andrewpatcarr/Origami-Robot/README.md

Origami-Robot
----
----
General repository for the origami worm
----

Programming has code for control of robot

CAD has all existing models for structures, mounts and other pieces of origami robot

log.md is a running log of work with the robot starting with my work in ME-400 in Fall 2024
