andrewpatcarr/Origami-Robot/log_photos/joystick_arduino_housing.jpg

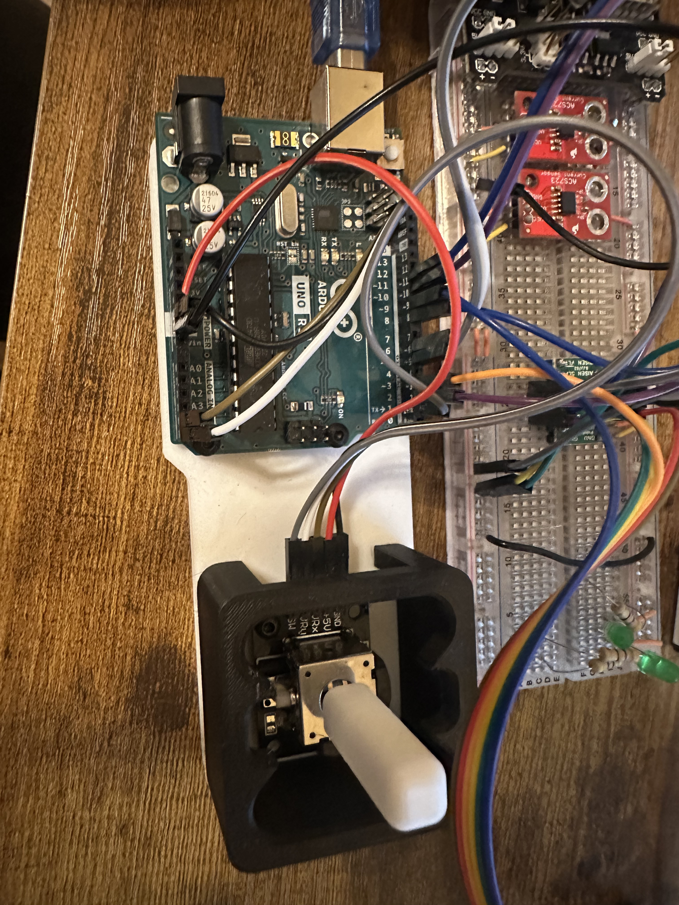
log_photos/joystick_arduino_housing.jpg
