andrewpatcarr/Origami-Robot/log_photos/motor_driver_screenshot_wordless.png

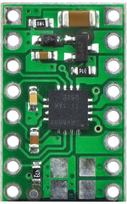
log_photos/motor_driver_screenshot_wordless.png
