andrewpatcarr/Origami-Robot/log_photos/origami_pattern.png

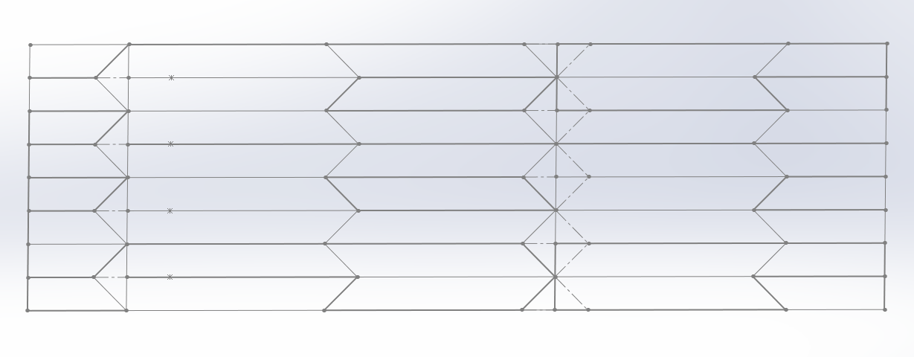
log_photos/origami_pattern.png
