andrewpatcarr/Origami-Robot/log_photos/worm_image_for_dim.jpg

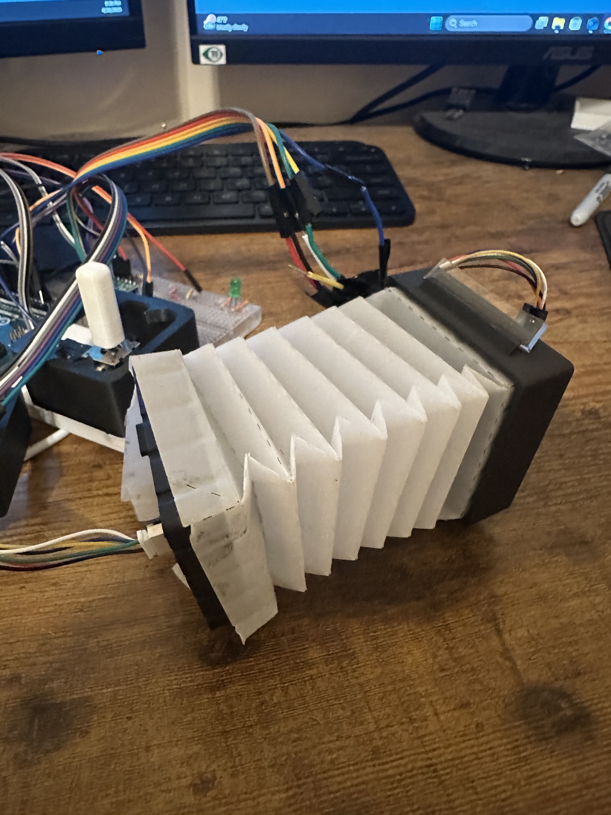
log_photos/worm_image_for_dim.jpg
