andrewpatcarr/Origami-Robot/Bill of Materials.xlsx

# | ITEM | Quantity | Price | Link | Total Price | Comments | Cost of materials
1 | Pololu 298:1 Micro Metal Gearmotor MP 6V with 12 CPR Encoder, Side Connector | 2 | $25.95 | www.pololu.com/product/5147 | $51.90 |  | $179.06
2 | Pololu DRV8833 Dual Motor Driver Carrier | 1 | $9.95 | www.pololu.com/product/2130 | $9.95 |  | without tax/shipping
3 | Arduino Uno R3 | 1 | $29.00 | www.amazon.com/Arduino-A000066-ARDUINO-UNO-R3 | $29.00 | can use offbrand one and will be cheaper
4 | Analog Joystick | 1 | $9.99 | www.amazon.com/Joystick-Controller | $9.99 | will have different base joystick so will need to change printed joystick to fit
5 | 6 Pin JST SH 1.0mm Cable Connector | 1 | $9.49 | www.amazon.com/dp/B0BKSNMC (https://www.amazon.com/dp/B0BKSNMCV4?ref=ppx_yo2ov_dt_b_fed_asin_title) | $9.49
6 | M1.6 x 3mm Round Flat Head Machine Screws | 1 | $5.99 | www.amazon.com/dp/B0CTMKH2CX (https://www.amazon.com/dp/B0CTMKH2CX?ref=ppx_yo2ov_dt_b_fed_asin_title&th=1) | $5.99
7 | PLA Filament | 1 | $13.99 | www.amazon.com/ELEGOO-Filament-Dimensional | $13.99
8 | Breadboard Power Supply Module | 1 | $6.99 | www.amazon.com/DIYables-Breadboard-Supply | $6.99
9 | Breadboard | 1 | $8.79 | www.amazon.com/Breadboards (https://www.amazon.com/Breadboards-Solderless-Breadboard-Distribution-Connecting/dp/B07DL13RZH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) | $8.79
10 | Multicolored Dupont Wire 120 pcs | 1 | $6.98 | www.amazon.com/Multicolored (https://www.amazon.com/Elegoo-EL-CP-004-Multicolored-Breadboard-arduino/dp/B01EV70C78) | $6.98
11 | Machine Screw Assortment Kit, M2 M3 M4 M5 | 1 | $25.99 | www.amazon.com/Machine-Assortment-Metric- | $25.99
12
13
14
15
16
17
18
19
20
21
