andrewpatcarr/Origami-Robot/CAD/SolidWorks/DC Pulley.SLDPRT

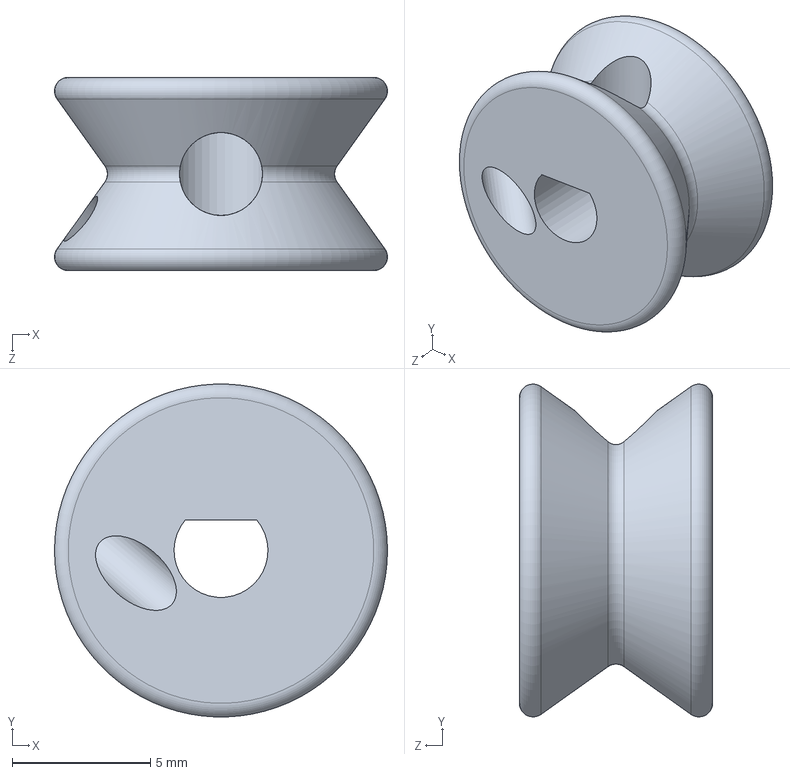
[picture p67: CAD file, 2025-03-13]
CAD/SolidWorks/DC Pulley.SLDPRT
12.1 x 12.0 x 7.00 mm
