andrewpatcarr/Origami-Robot/CAD/STLs/DC Motor/DC Motor Mount.STL

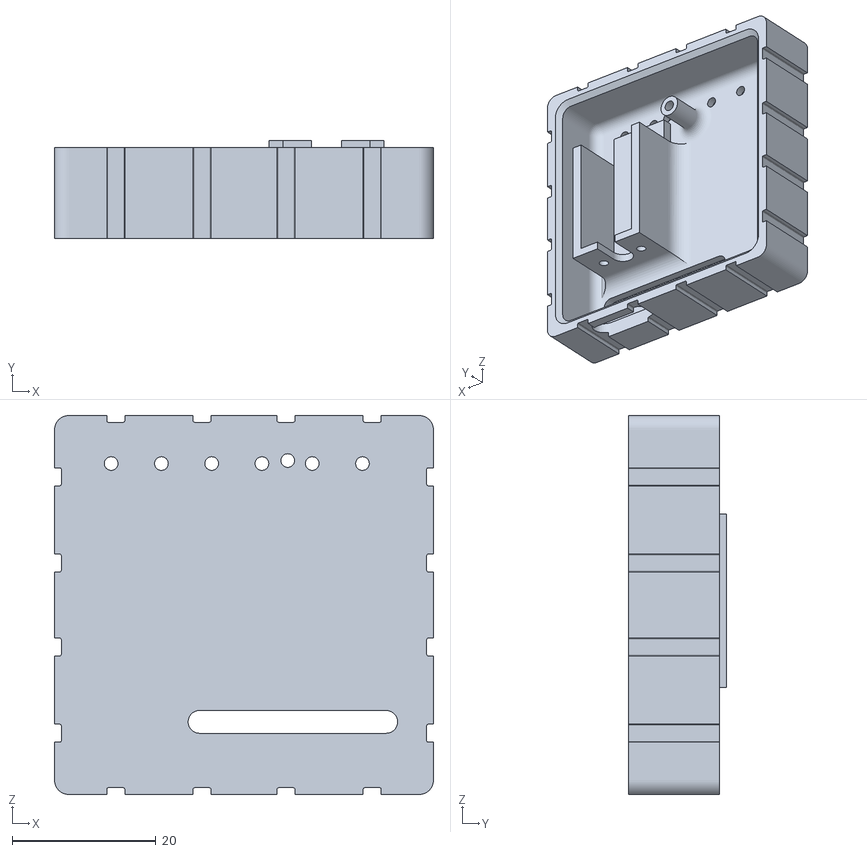
[picture p68: CAD file, 2025-02-09]
CAD/STLs/DC Motor/DC Motor Mount.STL
52.8 x 13.6 x 52.8
