andrewpatcarr/Origami-Robot/CAD/STLs/Friction Pads/Friction_straightangled_thinner^Worm_Robot.STL

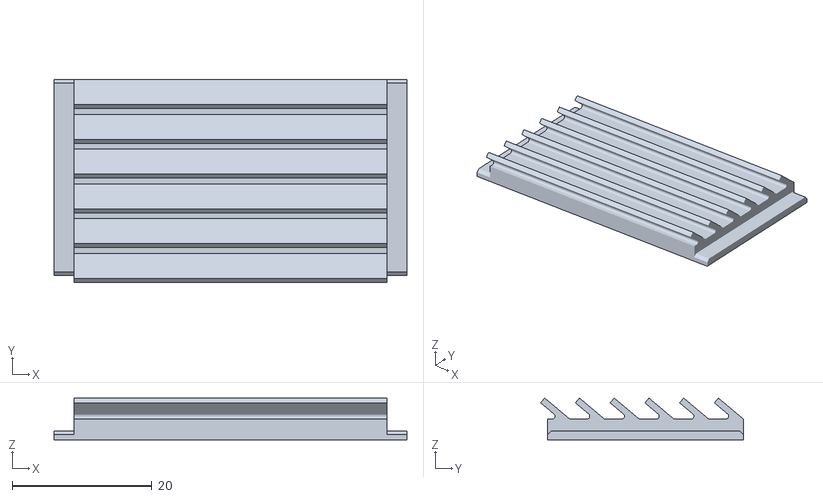
[picture p69: CAD file, 2025-02-07]
CAD/STLs/Friction Pads/Friction_straightangled_thinner^Worm_Robot.STL
50.5 x 29.0 x 6.00
