andrewpatcarr/Origami-Robot/CAD/STLs/Mount Clamp _PDMS_test_ right.STL

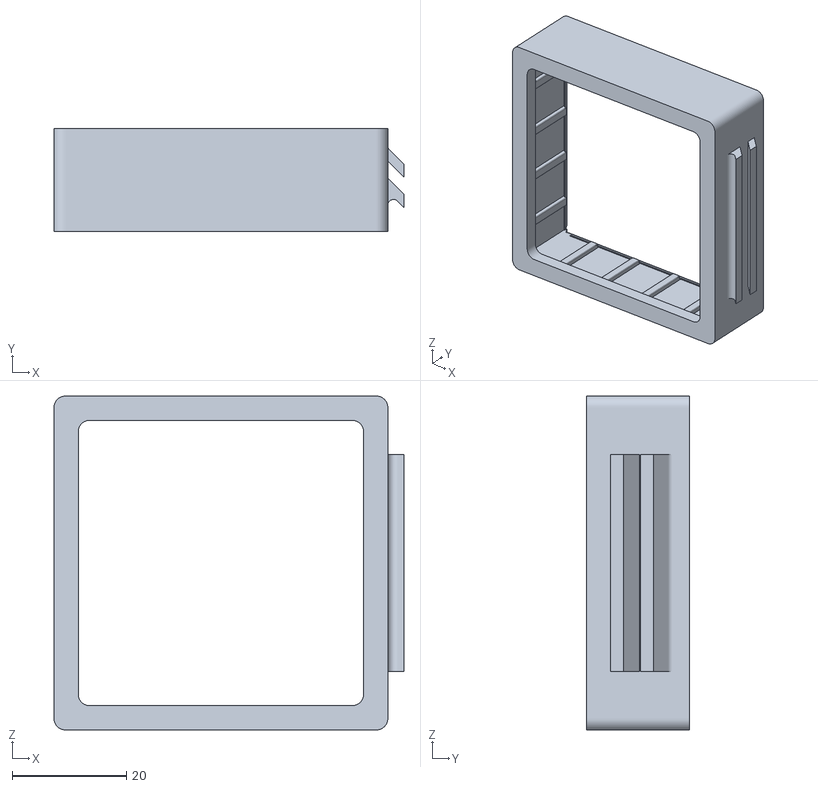
[picture p70: CAD file, 2025-03-14]
CAD/STLs/Mount Clamp _PDMS_test_ right.STL
61.3 x 18.0 x 58.5
