andrewpatcarr/Origami-Robot/CAD/STLs/DC Motor/DC Clamp^Worm_Robot.STL

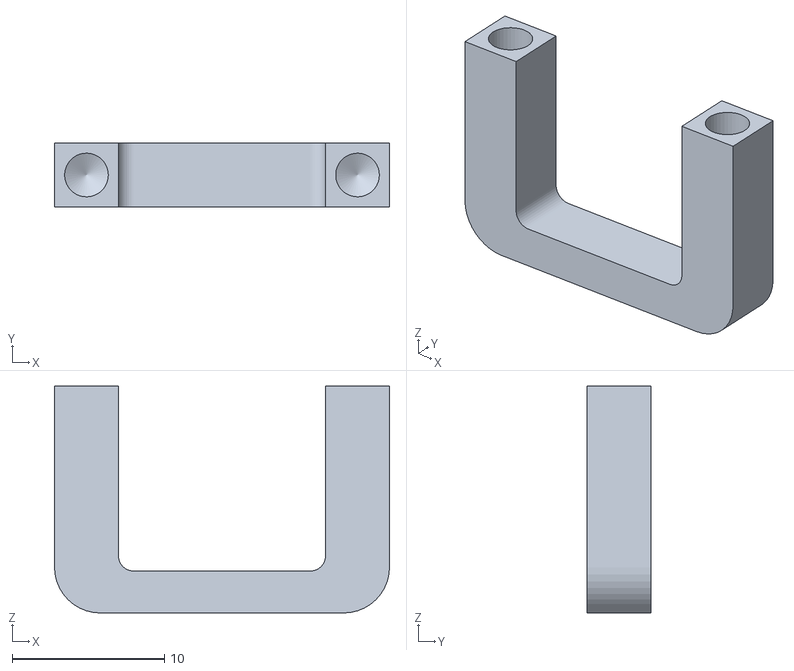
[picture p71: CAD file, 2025-02-07]
CAD/STLs/DC Motor/DC Clamp^Worm_Robot.STL
22.0 x 4.20 x 14.9
