andrewpatcarr/Origami-Robot/CAD/SolidWorks/Directional Friction Flexure_less.SLDPRT

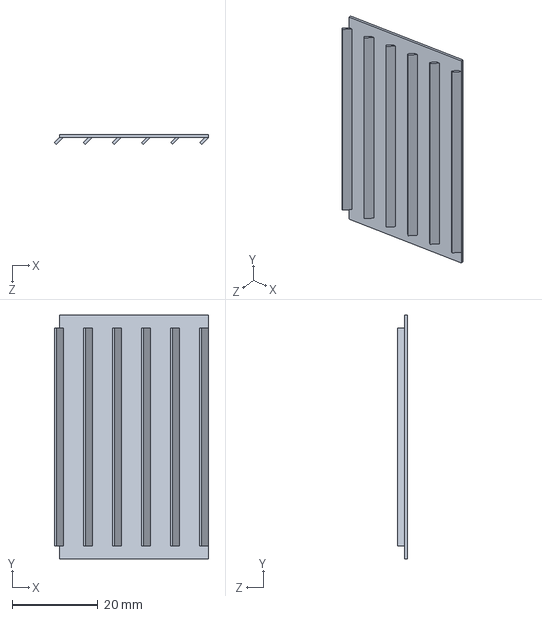
[picture p73: CAD file, 2025-02-07]
CAD/SolidWorks/Directional Friction Flexure_less.SLDPRT
35.9 x 56.8 x 2.30 mm
