andrewpatcarr/Origami-Robot/CAD/STLs/Friction Pads/Friction_straightangled_long_15_4^Worm_Robot.STL

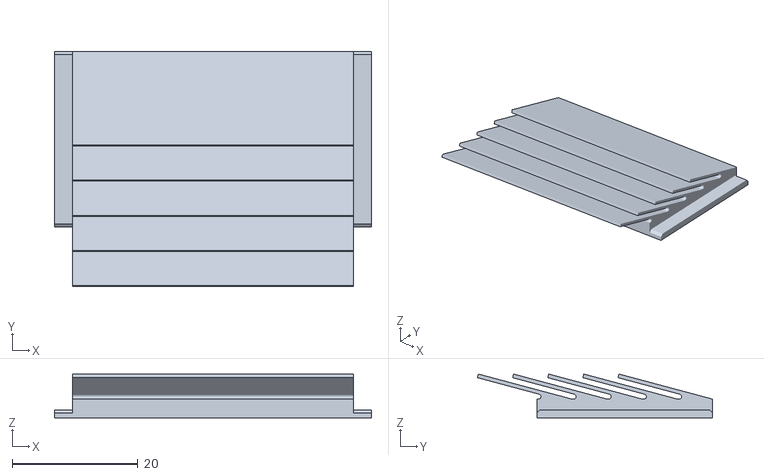
[picture p74: CAD file, 2025-02-07]
CAD/STLs/Friction Pads/Friction_straightangled_long_15_4^Worm_Robot.STL
50.5 x 37.5 x 7.00
