andrewpatcarr/Origami-Robot/CAD/SolidWorks/Servo Motor Mounts.sldprt

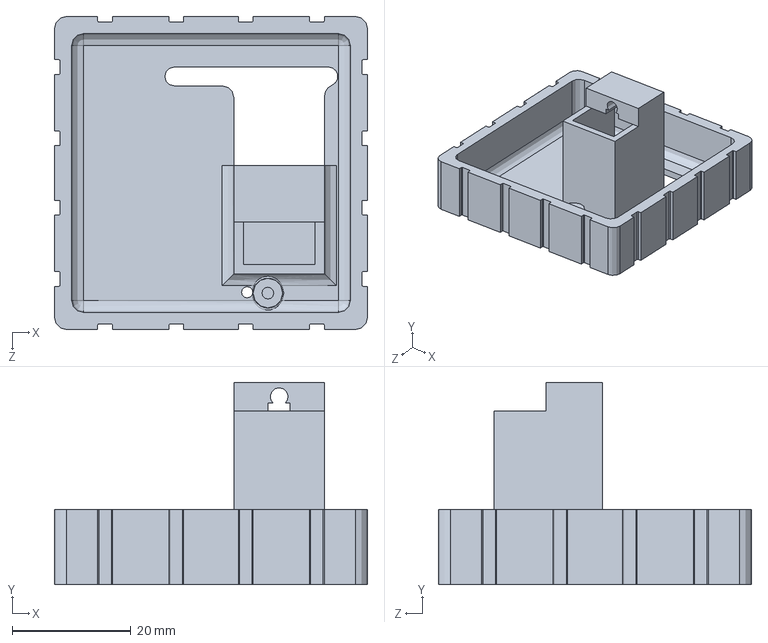
[picture p75: CAD file, 2025-02-07]
CAD/SolidWorks/Servo Motor Mounts.sldprt
52.8 x 34.1 x 52.8 mm
