andrewpatcarr/Origami-Robot/CAD/STLs/Friction Pads/Friction_straightangled_thinnest^Worm_Robot.STL

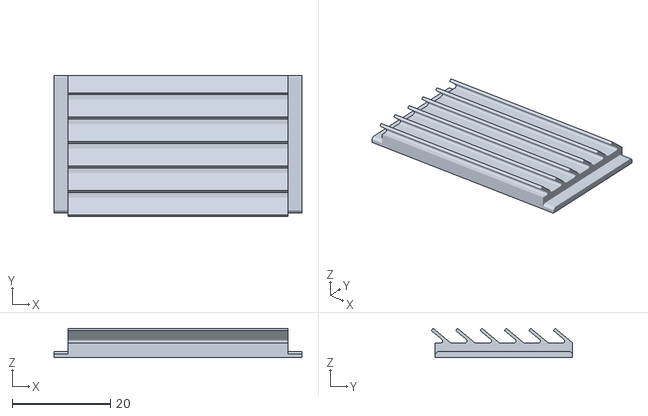
[picture p76: CAD file, 2025-02-07]
CAD/STLs/Friction Pads/Friction_straightangled_thinnest^Worm_Robot.STL
50.5 x 28.8 x 6.00
