andrewpatcarr/Origami-Robot/CAD/STLs/Mount Clamp Right_electromag^Worm_Robot.STL

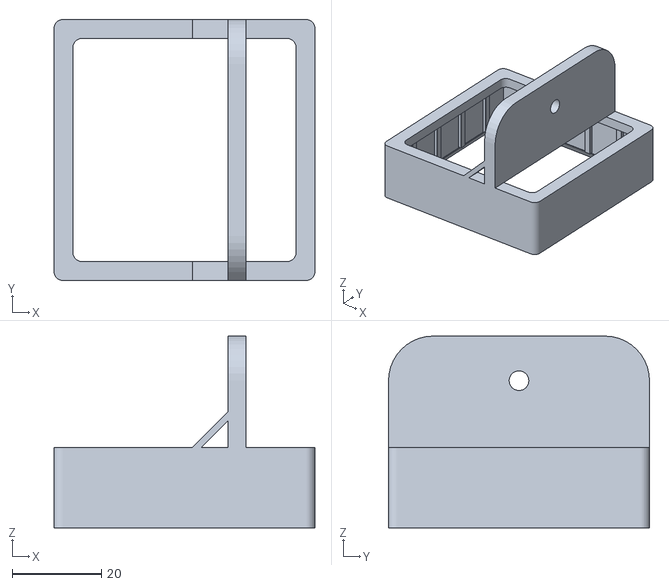
[picture p77: CAD file, 2025-02-09]
CAD/STLs/Mount Clamp Right_electromag^Worm_Robot.STL
58.5 x 58.5 x 43.0
