andrewpatcarr/Origami-Robot/CAD/SolidWorks/FS09R_Servo_Motor.SLDPRT

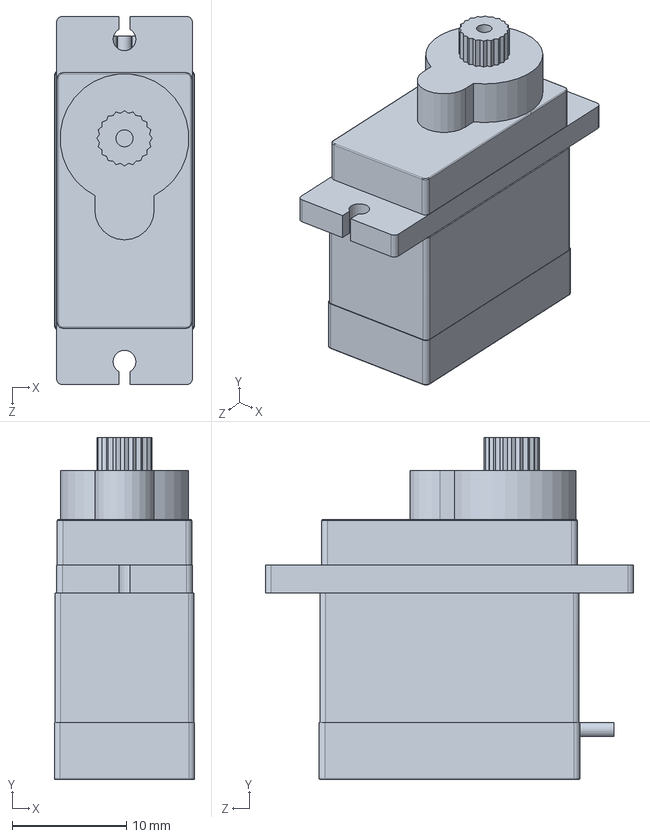
[picture p78: CAD file, 2025-02-07]
CAD/SolidWorks/FS09R_Servo_Motor.SLDPRT
12.3 x 30.0 x 32.2 mm
