andrewpatcarr/Origami-Robot/CAD/STLs/Friction Pads/Friction_straightangled_long_30_4.5^Worm_Robot.STL

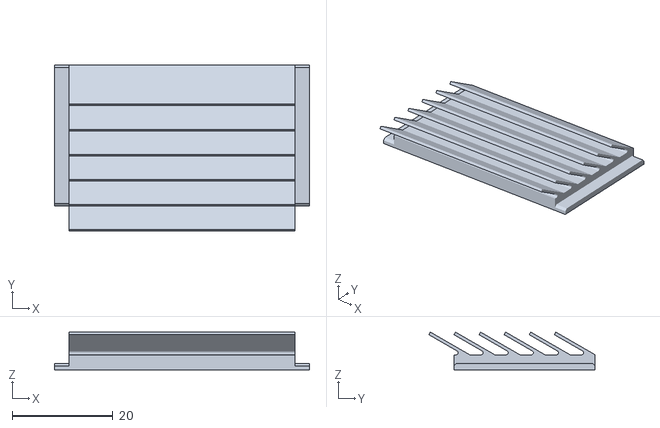
[picture p79: CAD file, 2025-02-07]
CAD/STLs/Friction Pads/Friction_straightangled_long_30_4.5^Worm_Robot.STL
50.5 x 32.9 x 7.50
