andrewpatcarr/Origami-Robot/CAD/SolidWorks/Servo Mount Clamp Test.SLDPRT

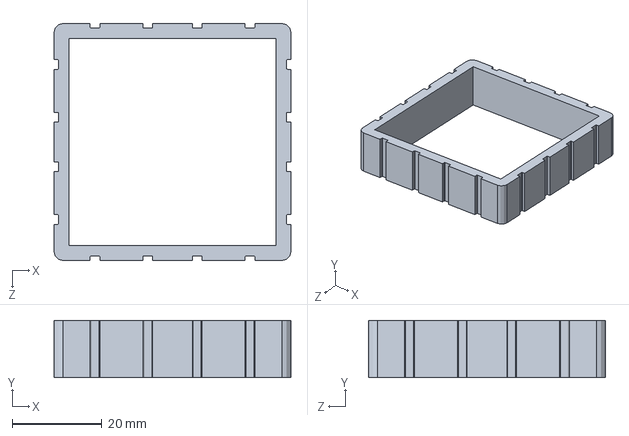
[picture p80: CAD file, 2025-02-07]
CAD/SolidWorks/Servo Mount Clamp Test.SLDPRT
52.8 x 12.7 x 52.8 mm
