andrewpatcarr/Origami-Robot/CAD/STLs/Mount Clamp^Worm_Robot.STL

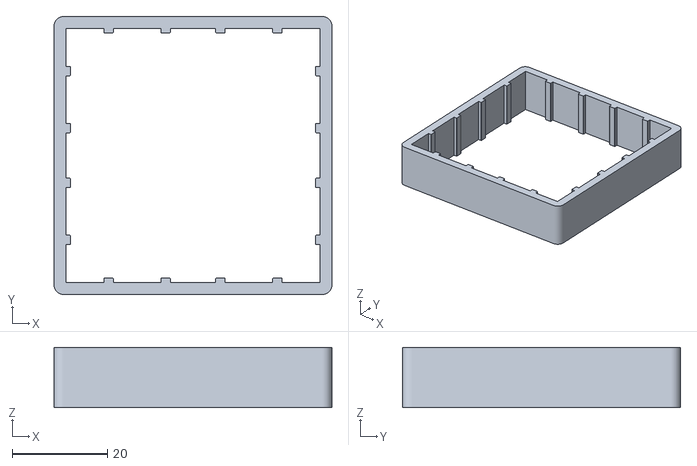
[picture p82: CAD file, 2025-02-07]
CAD/STLs/Mount Clamp^Worm_Robot.STL
58.5 x 58.5 x 12.7
