andrewpatcarr/Origami-Robot/CAD/SolidWorks/Directional Friction Pad.sldprt

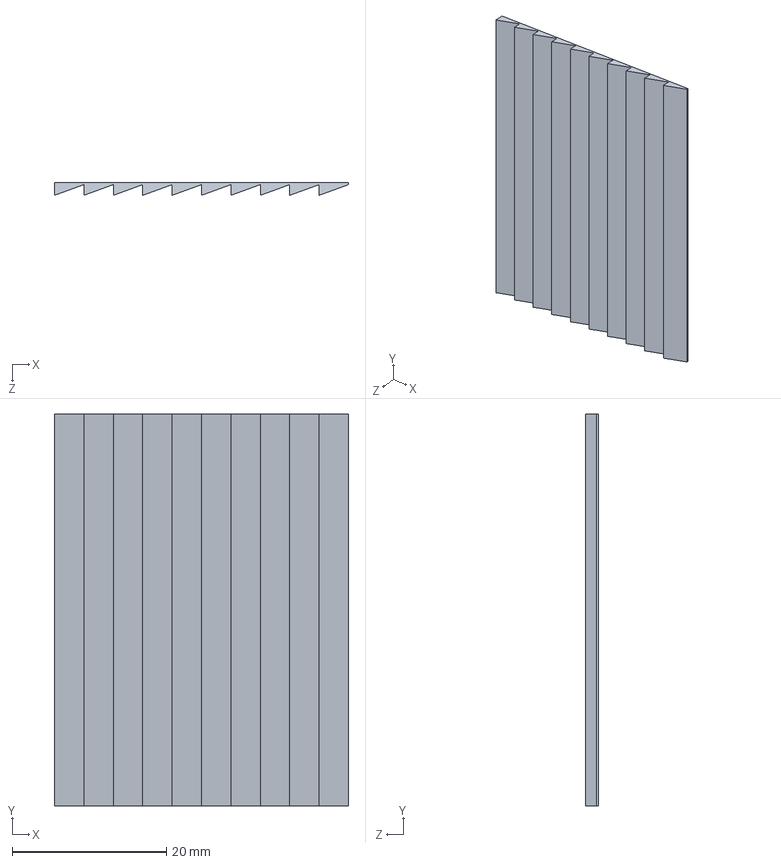
[picture p83: CAD file, 2025-02-07]
CAD/SolidWorks/Directional Friction Pad.sldprt
38.1 x 50.8 x 1.64 mm
