andrewpatcarr/Origami-Robot/CAD/STLs/Friction Pads/Friction_straightangled_long_25_4.5^Worm_Robot.STL

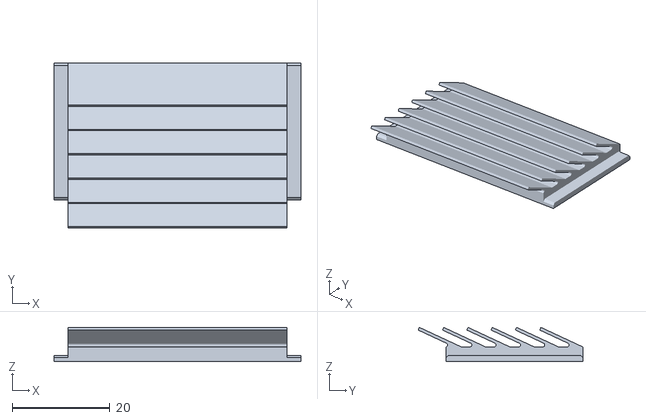
[picture p84: CAD file, 2025-02-07]
CAD/STLs/Friction Pads/Friction_straightangled_long_25_4.5^Worm_Robot.STL
50.5 x 33.7 x 7.00
