andrewpatcarr/Origami-Robot/CAD/STLs/Pulley Horn^Worm_Robot_4.6.STL

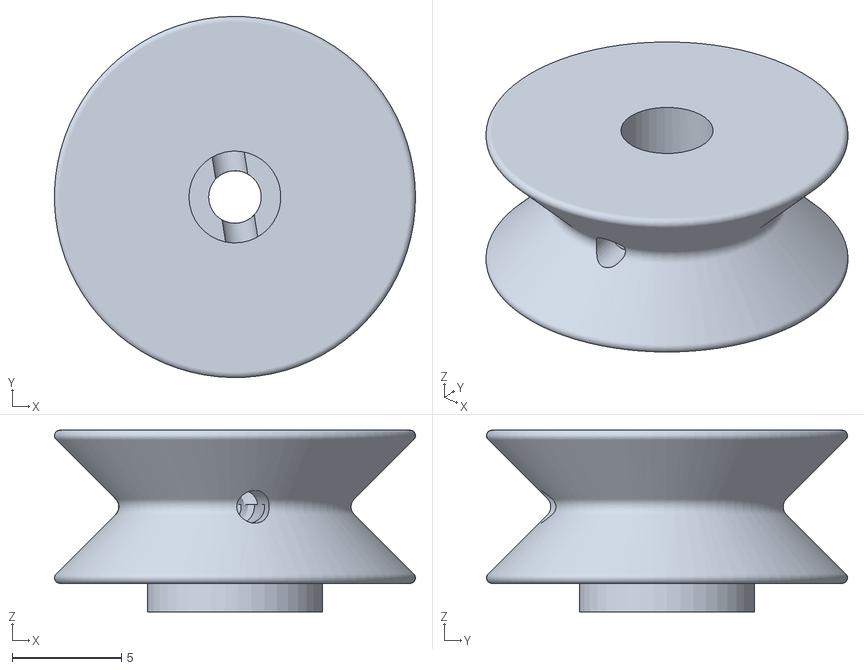
[picture p85: CAD file, 2025-02-07]
CAD/STLs/Pulley Horn^Worm_Robot_4.6.STL
16.5 x 16.5 x 8.30
