andrewpatcarr/Origami-Robot/CAD/STLs/Elevated Friction_1^Worm_Robot.STL

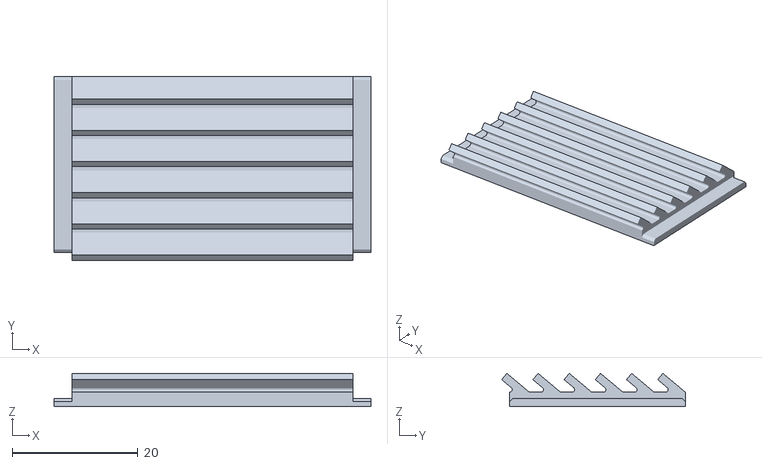
[picture p86: CAD file, 2025-02-07]
CAD/STLs/Elevated Friction_1^Worm_Robot.STL
50.5 x 29.3 x 5.30
