andrewpatcarr/Origami-Robot/CAD/STLs/Mount Clamp Left^Worm_Robot.STL

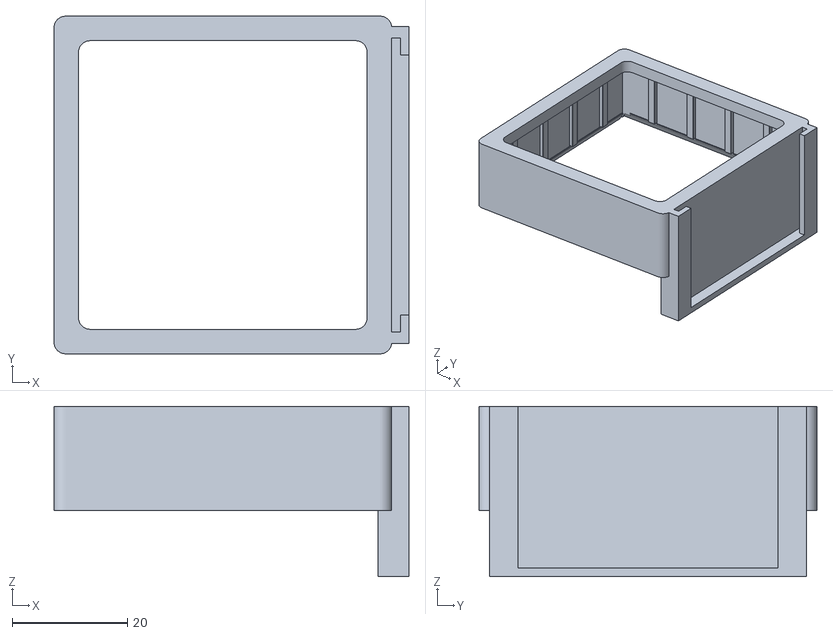
[picture p87: CAD file, 2025-02-07]
CAD/STLs/Mount Clamp Left^Worm_Robot.STL
61.5 x 58.5 x 29.5
