andrewpatcarr/Origami-Robot/CAD/SolidWorks/Directional Friction Flexure.sldprt

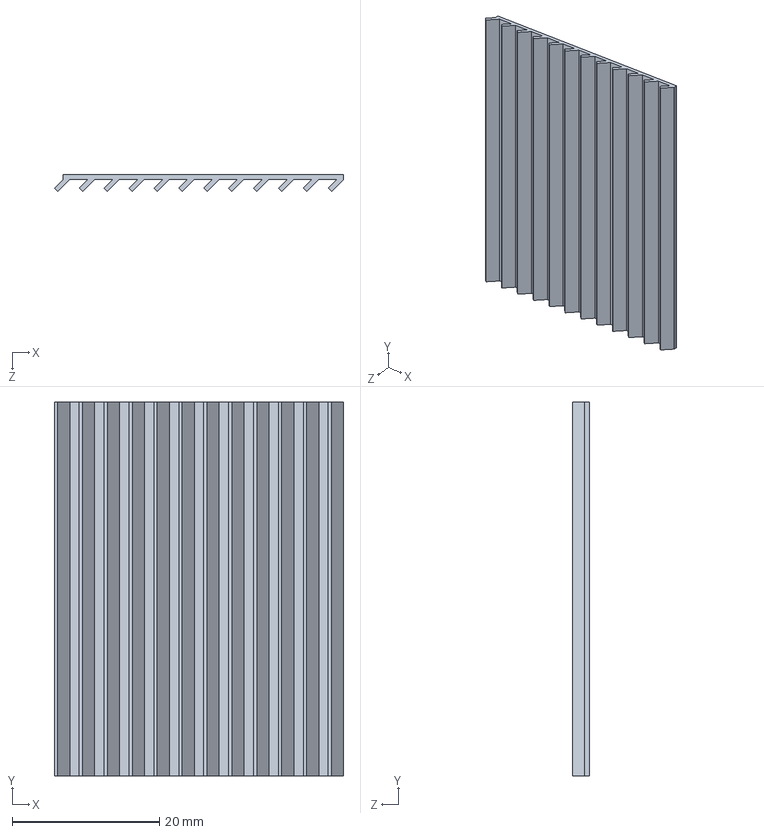
[picture p88: CAD file, 2025-02-07]
CAD/SolidWorks/Directional Friction Flexure.sldprt
39.3 x 50.8 x 2.30 mm
