andrewpatcarr/Origami-Robot/CAD/STLs/Joystick Base^Worm_Robot.STL

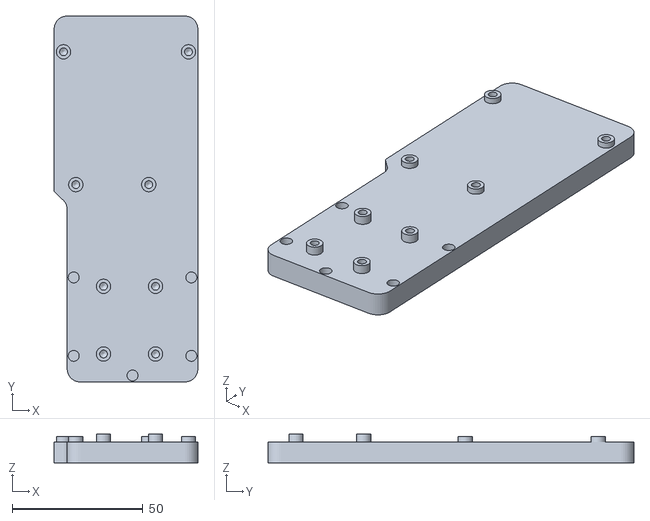
[picture p89: CAD file, 2025-02-07]
CAD/STLs/Joystick Base^Worm_Robot.STL
55.0 x 140.0 x 11.0
