andrewpatcarr/Origami-Robot/CAD/STLs/Mount Clamp^Worm_Robot_walled.STL

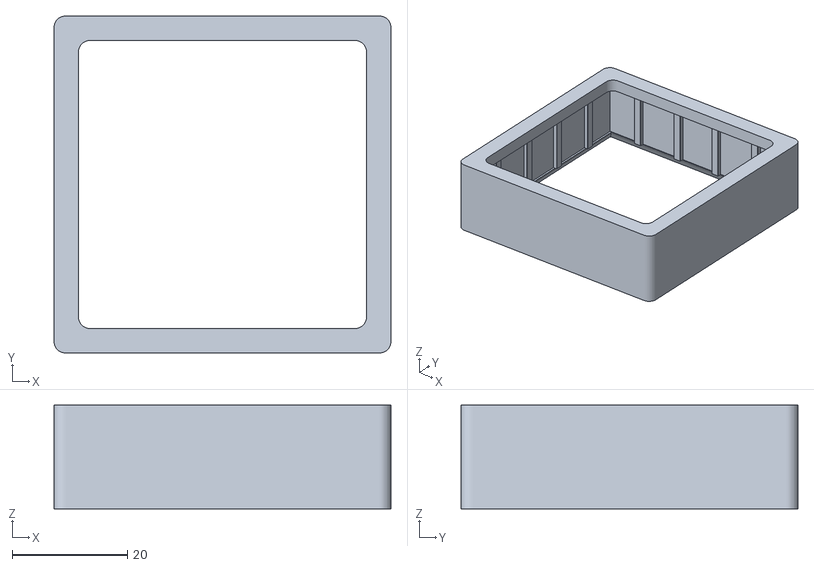
[picture p90: CAD file, 2025-02-07]
CAD/STLs/Mount Clamp^Worm_Robot_walled.STL
58.5 x 58.5 x 18.0
