andrewpatcarr/Origami-Robot/CAD/STLs/Matty Light Mount.SLDPRT

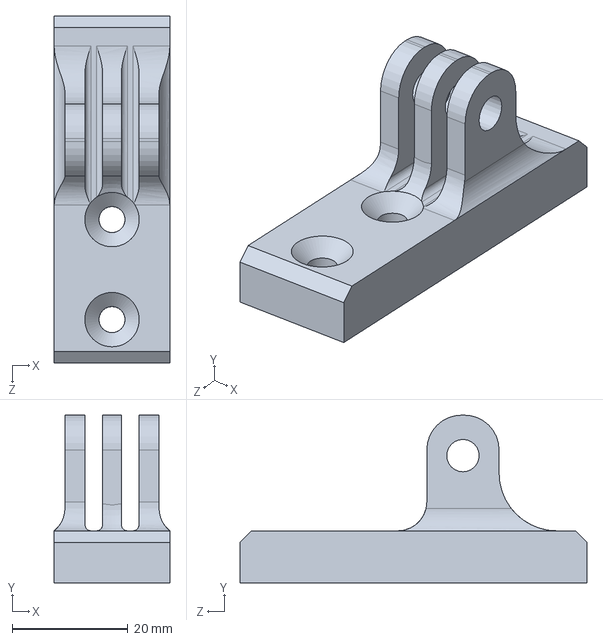
[picture p91: CAD file, 2025-02-07]
CAD/STLs/Matty Light Mount.SLDPRT
20.0 x 29.0 x 60.0 mm
