andrewpatcarr/Origami-Robot/CAD/STLs/Directional Friction Flexure_og.STL

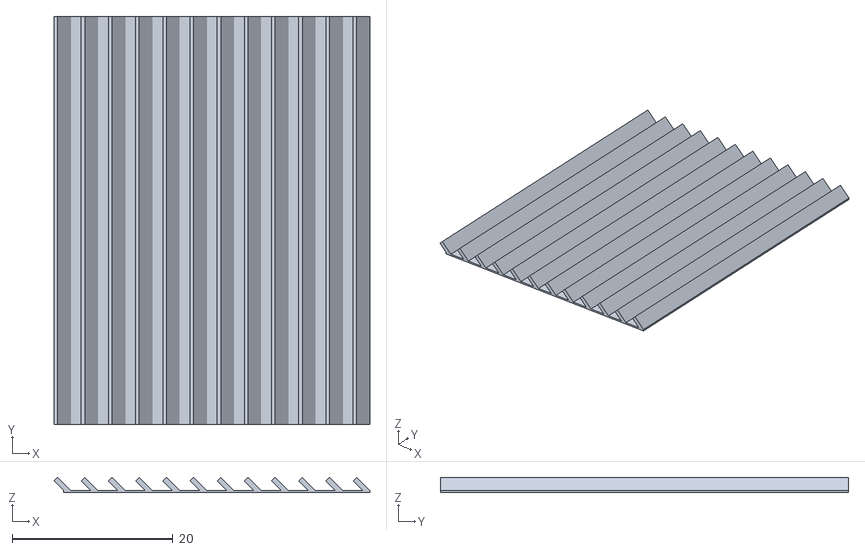
[picture p92: CAD file, 2025-02-07]
CAD/STLs/Directional Friction Flexure_og.STL
39.3 x 50.8 x 1.90
