andrewpatcarr/Origami-Robot/CAD/STLs/Gear box^Worm_Robot.STL

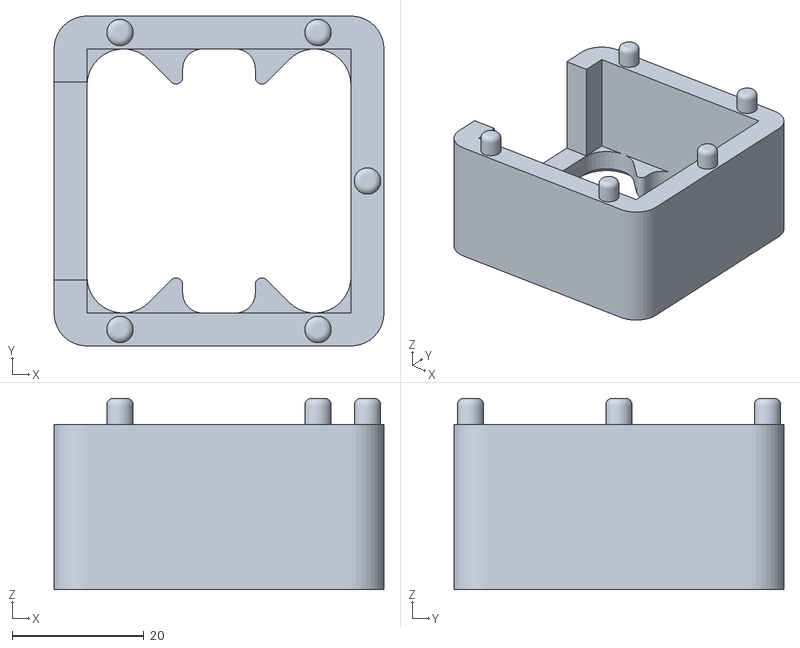
[picture p93: CAD file, 2025-02-07]
CAD/STLs/Gear box^Worm_Robot.STL
50.0 x 50.0 x 29.0
