andrewpatcarr/Origami-Robot/CAD/STLs/Joystick Top^Worm_Robot.STL

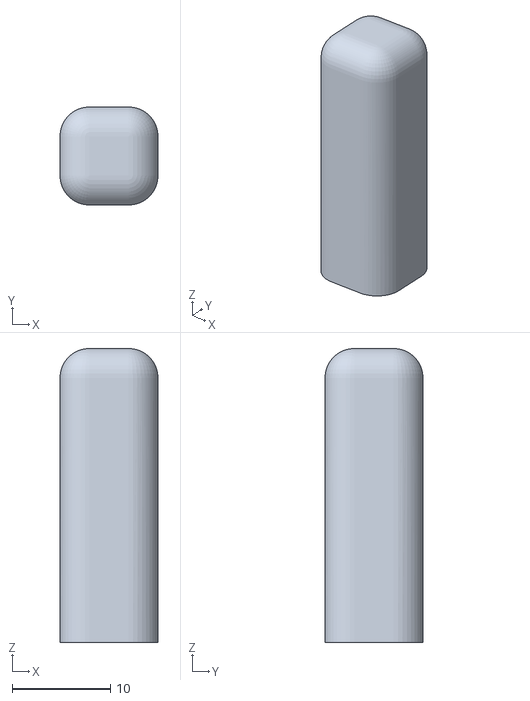
[picture p94: CAD file, 2025-02-07]
CAD/STLs/Joystick Top^Worm_Robot.STL
10.0 x 10.0 x 30.0
