andrewpatcarr/Origami-Robot/(list of files, cad)

Other CAD files:
CAD/SolidWorks/DC Motor Mount.SLDPRT
CAD/STLs/Mount Clamp _PDMS_test.STL
CAD/STLs/DC Pulley_wider.STL
CAD/STLs/Mount Clamp Left_electromag^Worm_Robot.STL
CAD/SolidWorks/Pulley Horn^Worm_Robot.SLDPRT
CAD/STLs/Mount Clamp Right^Worm_Robot.STL
CAD/STLs/Directional Friction Flexure_og_thick.STL
CAD/STLs/Servo Motor Mount.STL
CAD/STLs/Pulley Horn^Worm_Robot_4.7.STL
CAD/STLs/DC Pulley.STL
CAD/STLs/Directional Friction Flexure_less.STL
CAD/STLs/Pulley Horn^Worm_Robot.STL
CAD/STLs/Servo Motor Mounts.STL
CAD/STLs/Servo Mount Clamp Test.STL
