andrewpatcarr/Origami-Robot/log_photos/Origami motor torque.pdf

TOPVIEW | WWM
or

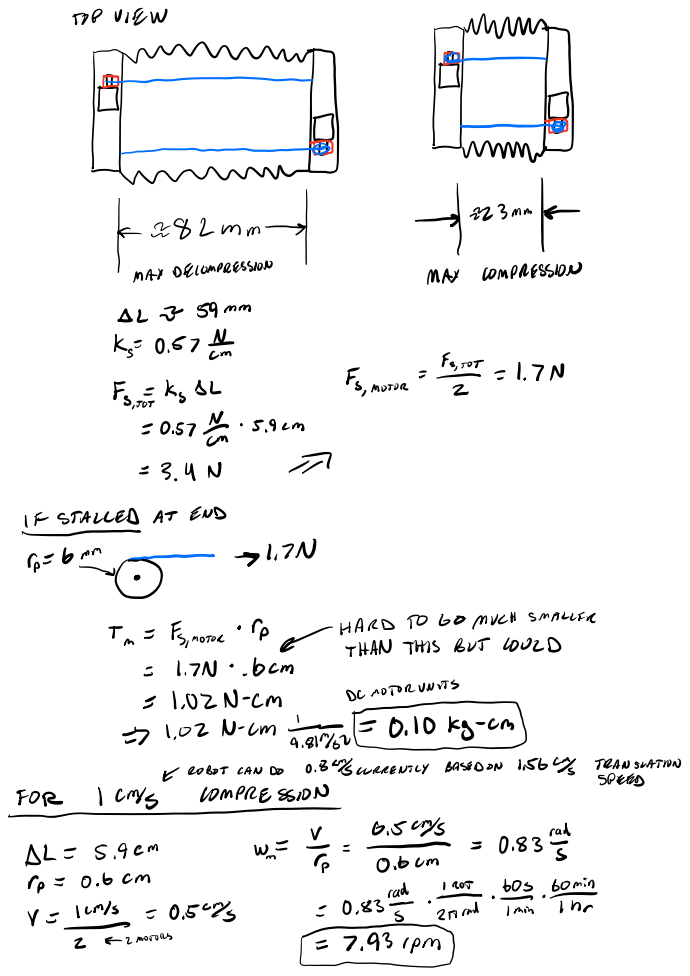
[picture p96: page 1]
TITTIES; MAXDECOMPRESSION; MAX COMPRESSION; Fsmotor; Tm Emore.ba faPFns8Ehjti 1.7N_ 6cm 1.02N Cm; lozn.am; EEoiiiiso; noises; iii; fit

Fs.EE Em stem

ROBOTCANDo 0.8 SWERENTLY BASEDON 10564s Typagggation
