andrewpatcarr/Origami-Robot/(commit log)

2025-02-07 move stuff from other repo
    [Bill of Materials.xlsx, DC Clamp^Worm_Robot.STL, DC Motor Mount.SLDPRT, DC Motor Mount.STL, DC Pulley.SLDPRT, DC Pulley.STL, Directional Friction Flexure.sldprt, Directional Friction Flexure_less.SLDPRT]
2025-02-07 remove cv stuff
    [results.csv, results.xlsx]
2025-02-09 add electromag stuff
    [DC Motor Mount.SLDPRT, DC Motor Mount.STL, Mount Clamp Left_electromag^Worm_Robot.STL, Mount Clamp Right_electromag^Worm_Robot.STL]
2025-03-13 create pdms mount
    [DC Pulley.SLDPRT, DC Pulley.STL, DC Pulley_wider.STL, Mount Clamp _PDMS_test.STL, Mount Clamp _PDMS_test_ right.STL]
2025-03-14 add pdms clamps
    [Mount Clamp _PDMS_test_ right.STL]
